bennbolton/BallBalancer/CAD/protractor image.png

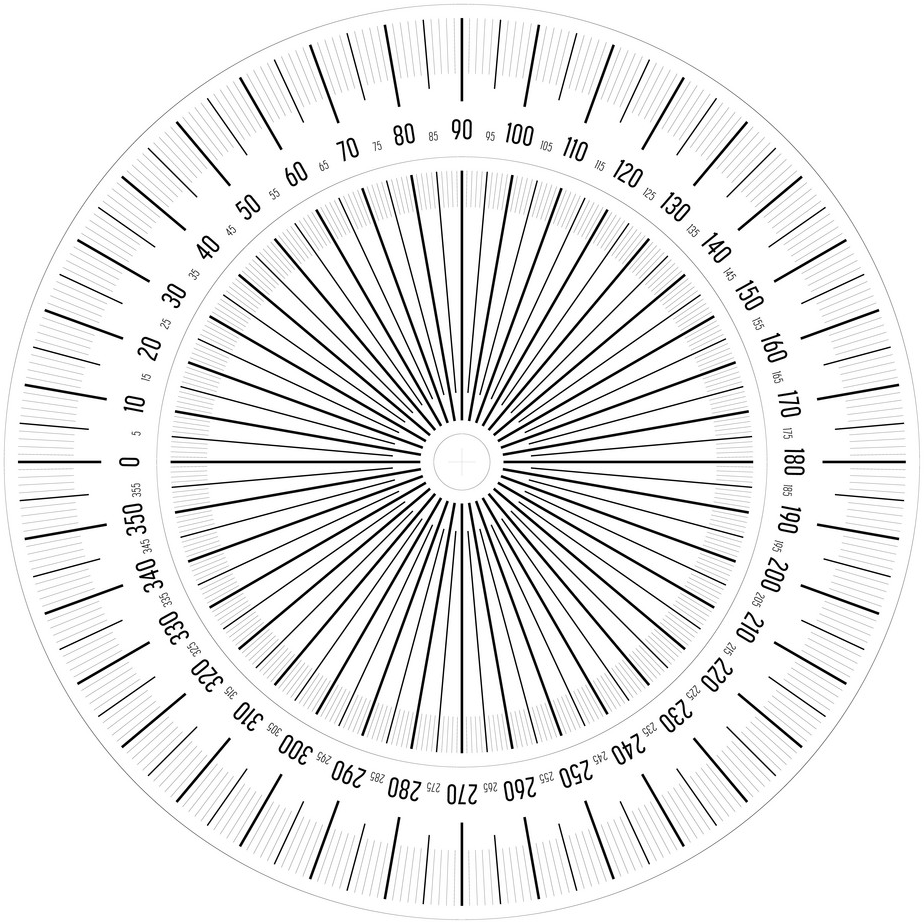
CAD/protractor image.png
