bennbolton/BallBalancer/Submissions/assets/mountRender.JPG

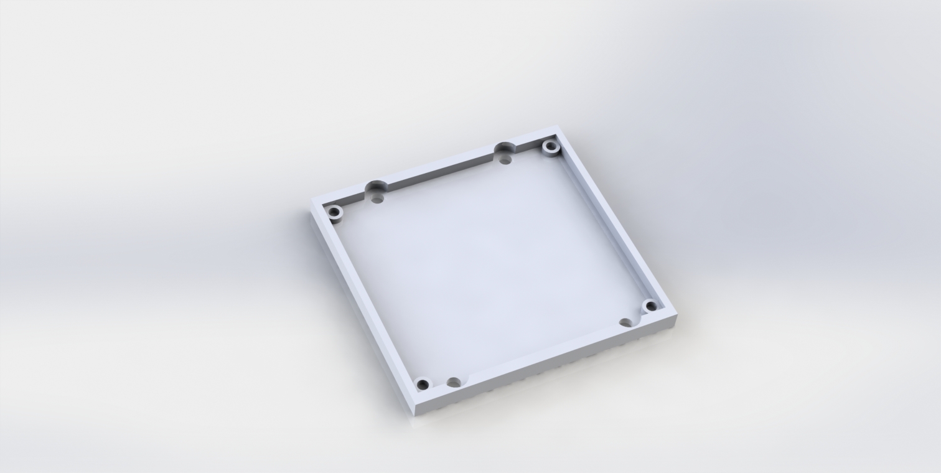
Submissions/assets/mountRender.JPG
