bennbolton/BallBalancer/Submissions/assets/response2.png

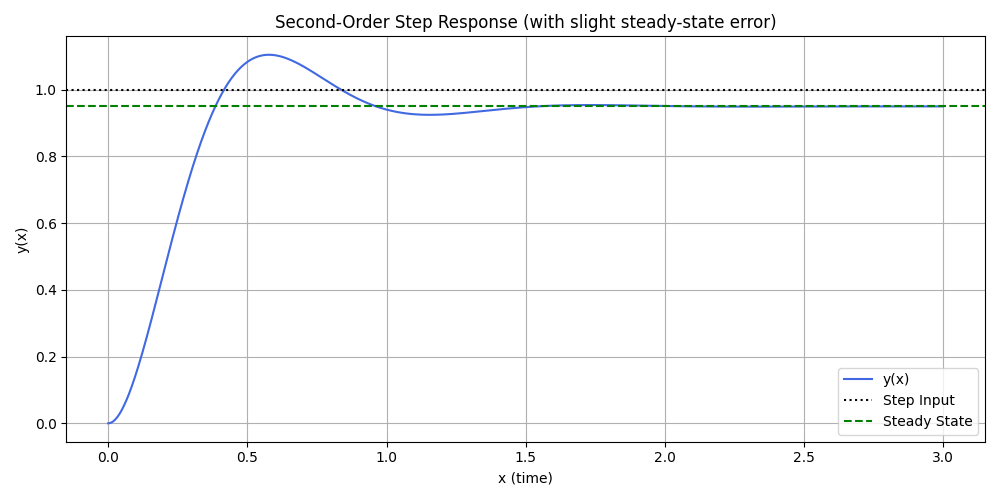
Submissions/assets/response2.png
