bennbolton/BallBalancer/Submissions/assets/response.png

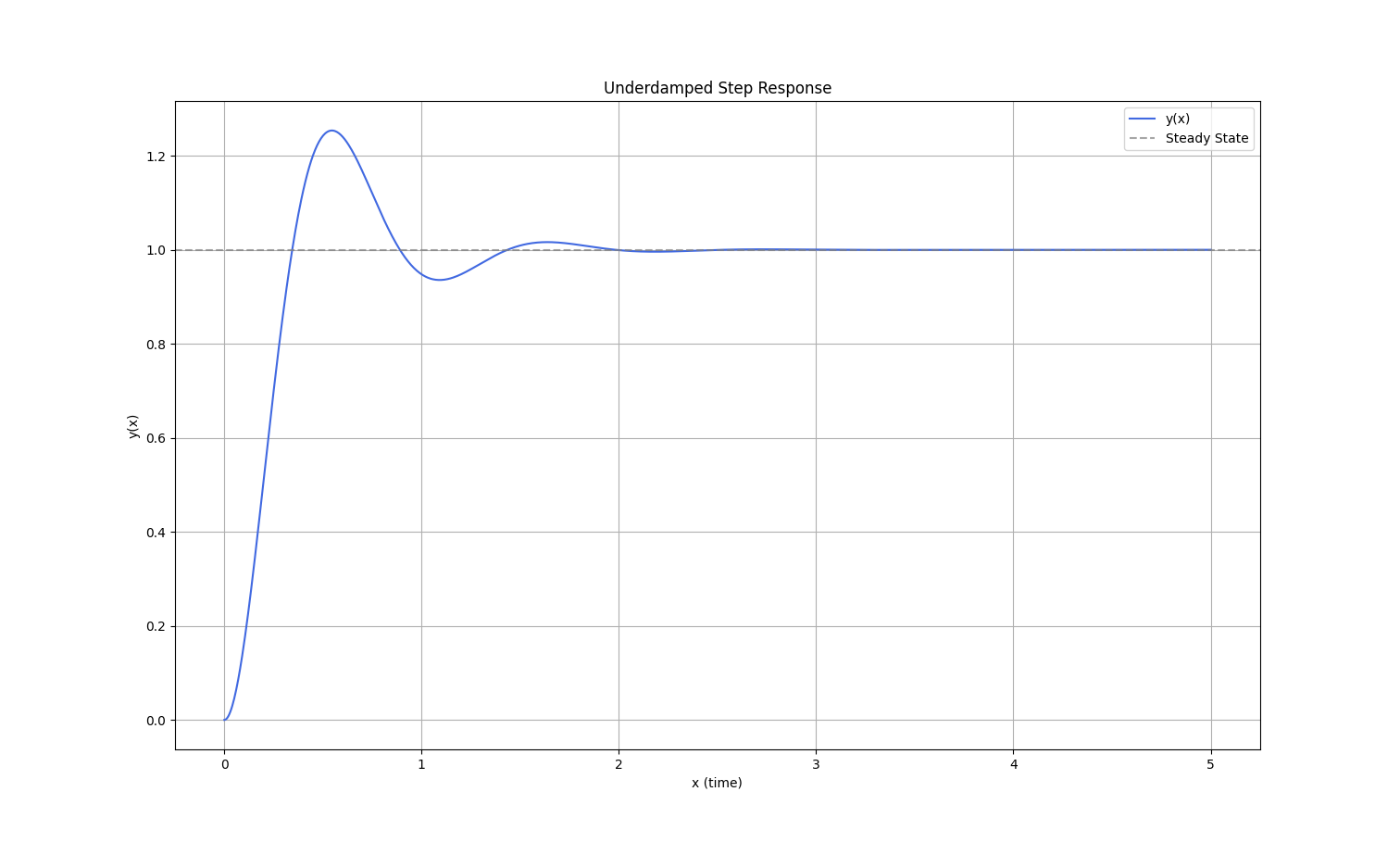
Submissions/assets/response.png
