bennbolton/BallBalancer/CAD/Parts/ESP32 Adapter mount 2.SLDPRT

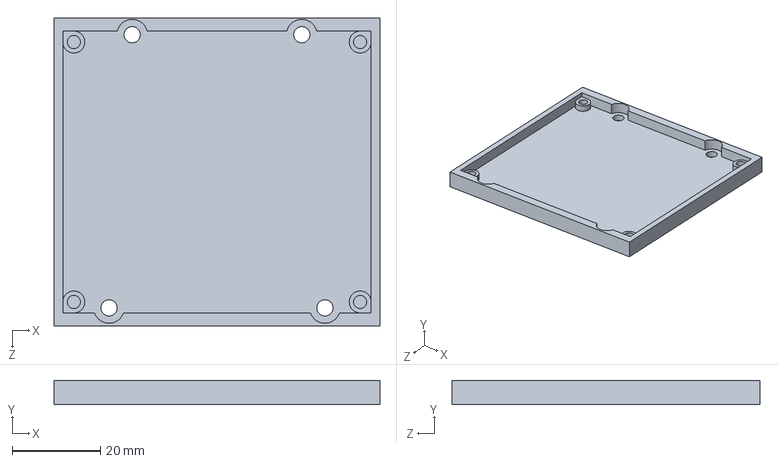
[picture p23: CAD file, 2025-08-05]
CAD/Parts/ESP32 Adapter mount 2.SLDPRT
74.0 x 5.50 x 70.0 mm
