bennbolton/BallBalancer/CAD/STL1/Assem1 - NEMA 23 - 76mm.prt-1.STL

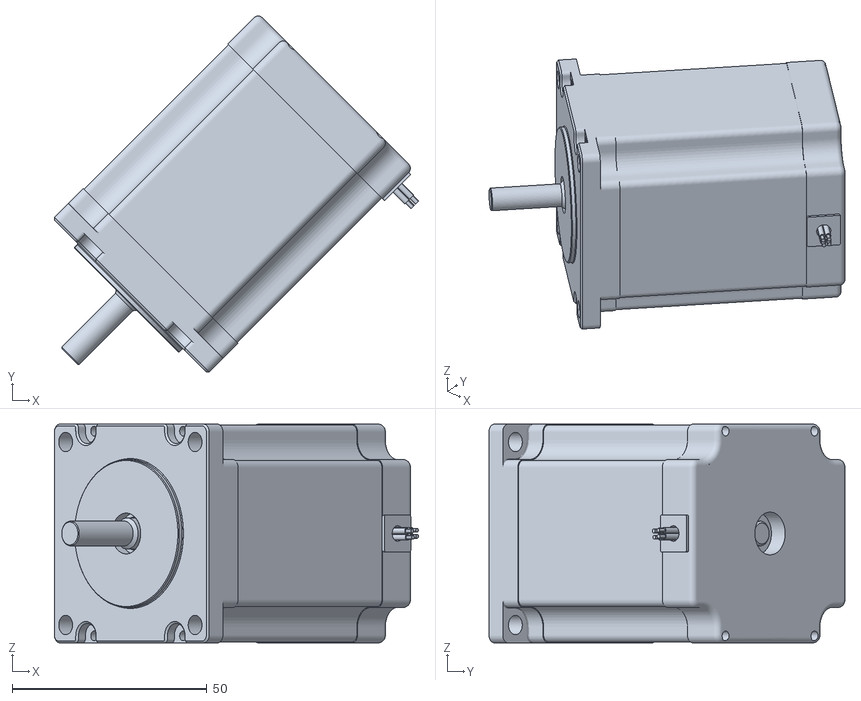
[picture p24: CAD file, 2025-08-05]
CAD/STL1/Assem1 - NEMA 23 - 76mm.prt-1.STL
93.5 x 91.4 x 56.2
