bennbolton/BallBalancer/CAD/Parts/BowlingBall.SLDPRT

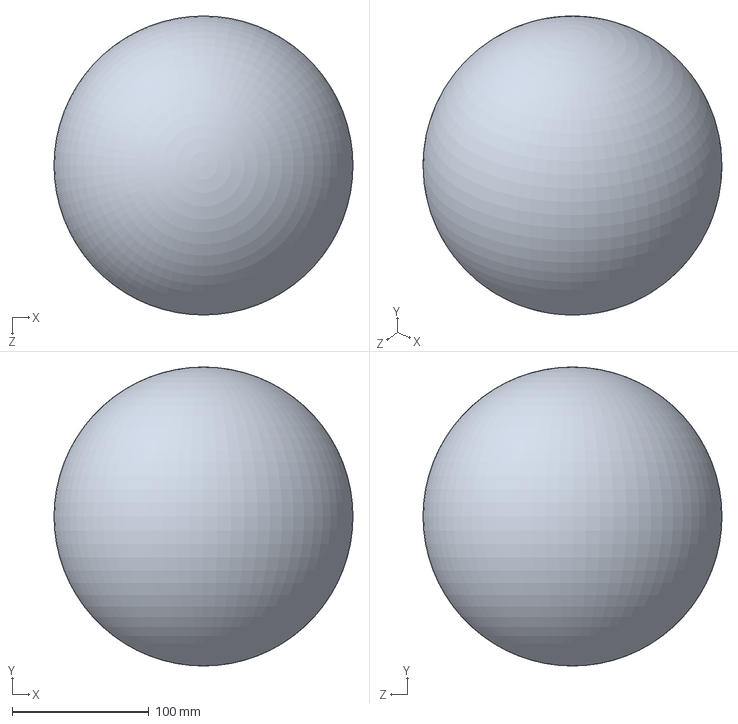
[picture p25: CAD file, 2025-08-05]
CAD/Parts/BowlingBall.SLDPRT
218.3 x 218.3 x 218.3 mm
