bennbolton/BallBalancer/CAD/STL1/Assem1 - nema23 45 degree mounting bracket.prt-1.STL

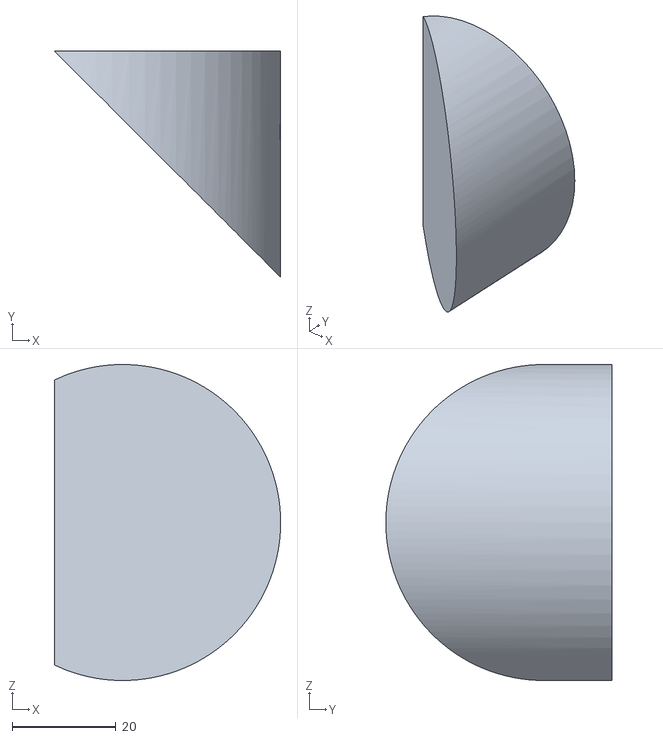
[picture p26: CAD file, 2025-08-05]
CAD/STL1/Assem1 - nema23 45 degree mounting bracket.prt-1.STL
43.7 x 43.7 x 61.0
