bennbolton/BallBalancer/CAD/Parts/OmniWheel.SLDPRT

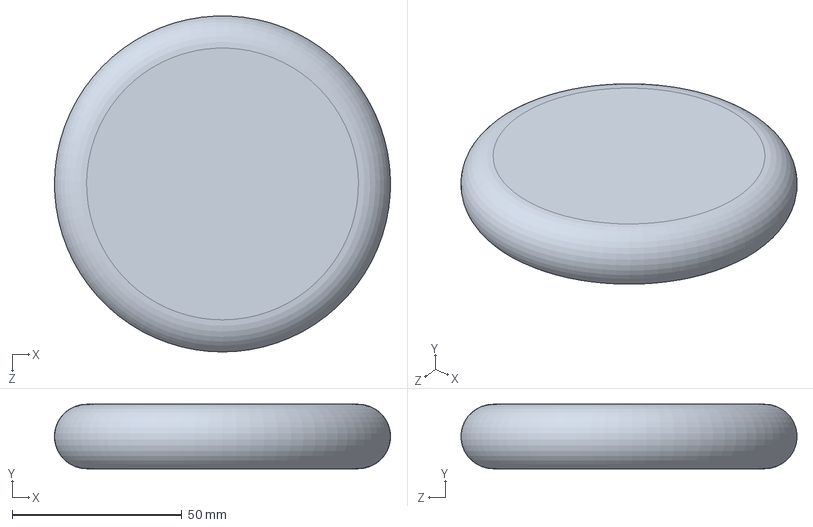
[picture p27: CAD file, 2025-08-05]
CAD/Parts/OmniWheel.SLDPRT
98.9 x 19.0 x 98.9 mm
