bennbolton/BallBalancer/CAD/STL1/Assem1 - TopPlate-2.STL

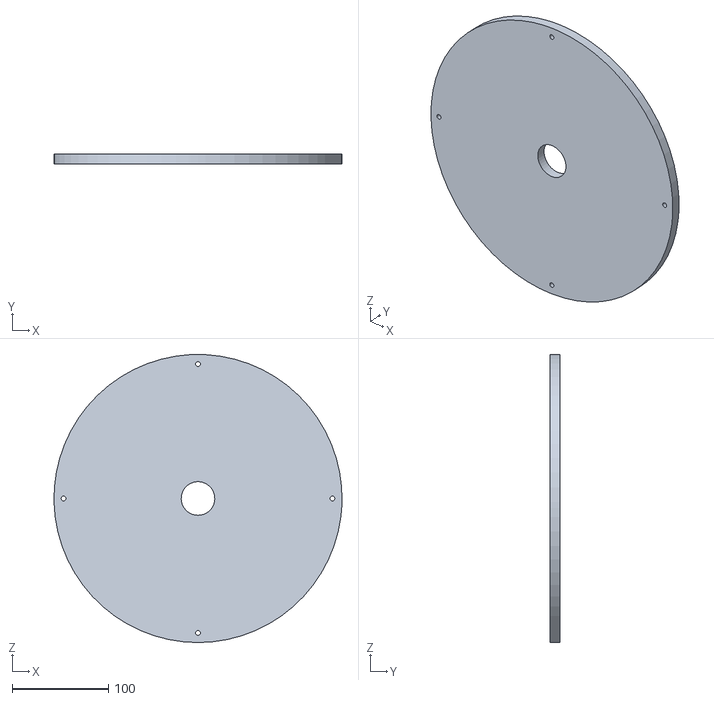
[picture p28: CAD file, 2025-08-05]
CAD/STL1/Assem1 - TopPlate-2.STL
299.9 x 10.0 x 300.0
