bennbolton/BallBalancer/CAD/STL1/Assem1 - SupportPole-3.STL

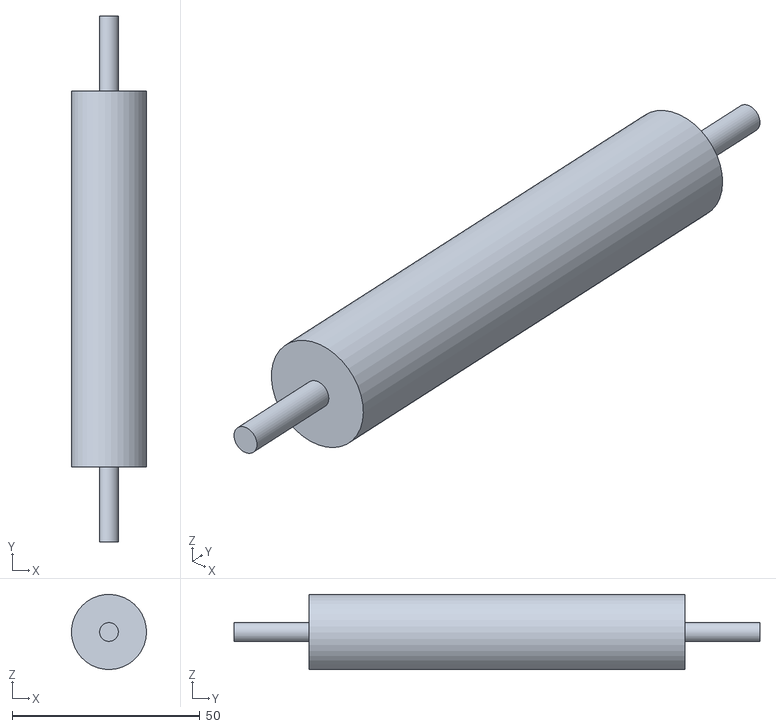
[picture p29: CAD file, 2025-08-05]
CAD/STL1/Assem1 - SupportPole-3.STL
20.0 x 140.0 x 20.0
