bennbolton/BallBalancer/CAD/Parts/ESP32 Adapter mount.SLDPRT

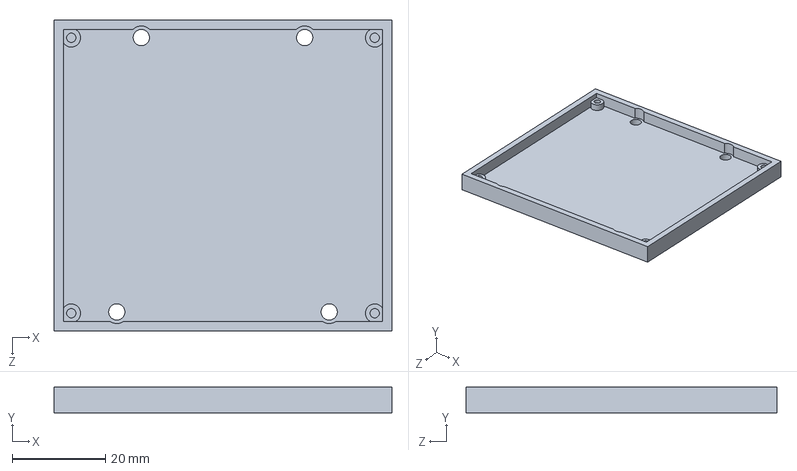
[picture p30: CAD file, 2025-08-05]
CAD/Parts/ESP32 Adapter mount.SLDPRT
72.4 x 5.50 x 66.6 mm
