bennbolton/BallBalancer/CAD/STL1/Assem1 - nema23 45 degree mounting bracket.prt-5.STL

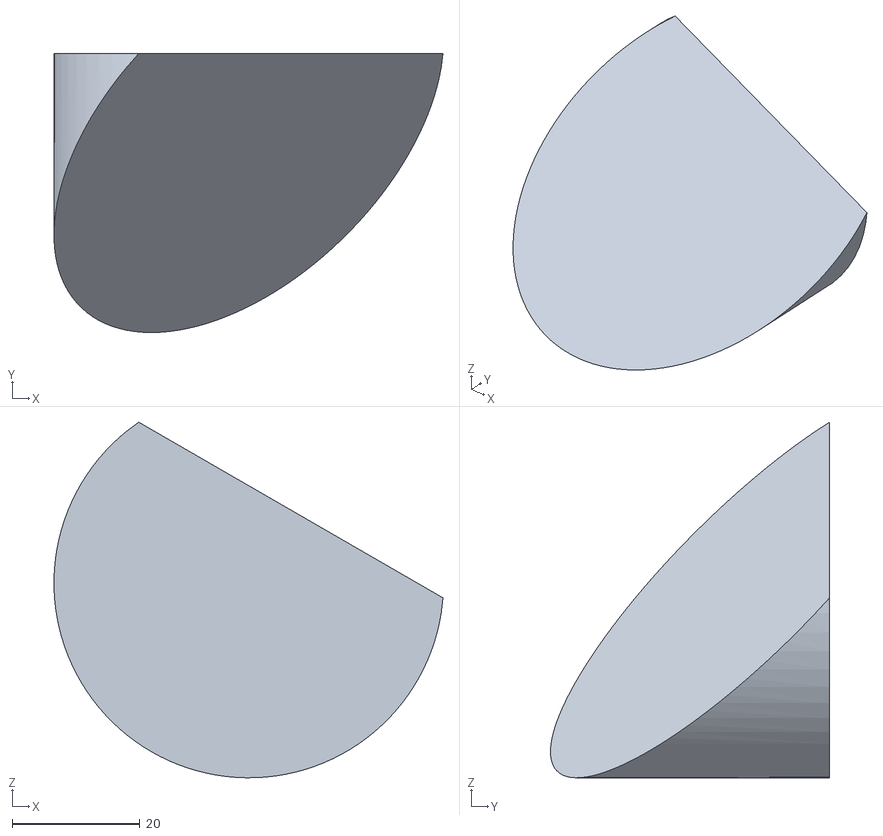
[picture p31: CAD file, 2025-08-05]
CAD/STL1/Assem1 - nema23 45 degree mounting bracket.prt-5.STL
60.9 x 43.7 x 55.7
