bennbolton/BallBalancer/CAD/Parts/ball_holder.SLDPRT

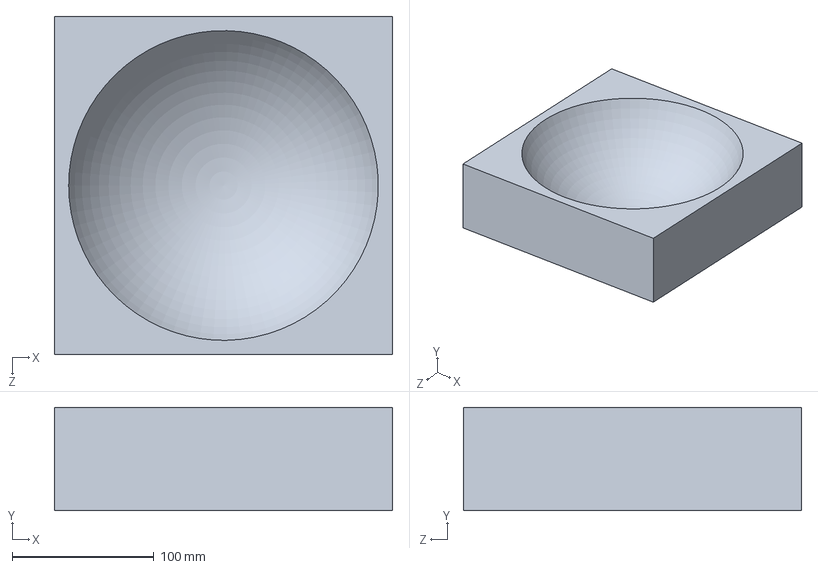
[picture p32: CAD file, 2025-08-05]
CAD/Parts/ball_holder.SLDPRT
238.3 x 72.8 x 238.3 mm
