bennbolton/BallBalancer/CAD/STL1/Assem1 - OmniWheel-1.STL

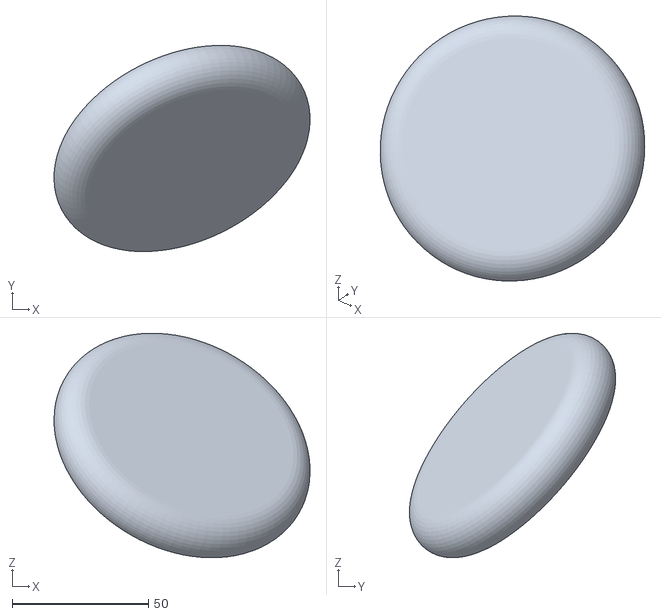
[picture p33: CAD file, 2025-08-05]
CAD/STL1/Assem1 - OmniWheel-1.STL
93.8 x 75.5 x 82.2
