bennbolton/BallBalancer/CAD/STL1/Assem1 - NEMA 23 - 76mm.prt-3.STL

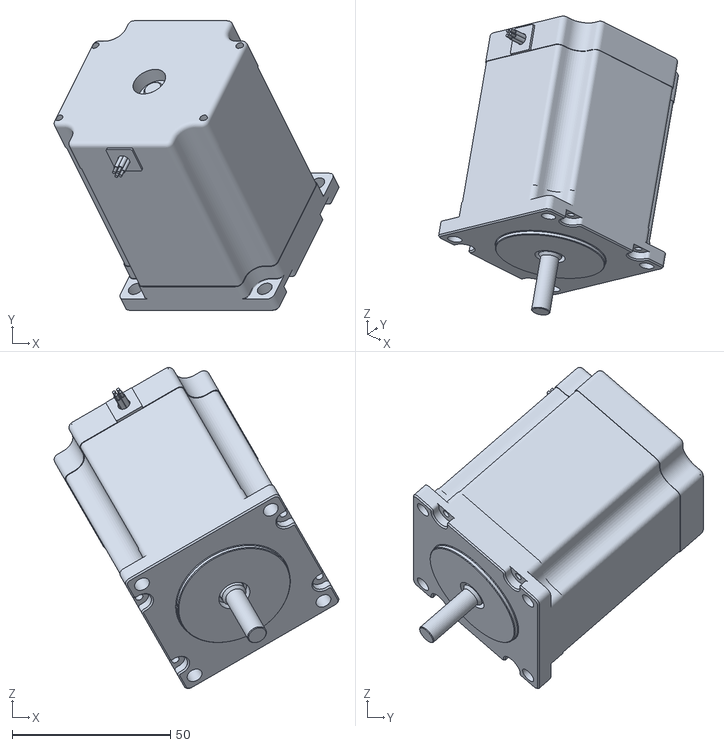
[picture p34: CAD file, 2025-08-05]
CAD/STL1/Assem1 - NEMA 23 - 76mm.prt-3.STL
89.9 x 91.4 x 101.4
