bennbolton/BallBalancer/CAD/STL1/Assem1 - OmniWheel-3.STL

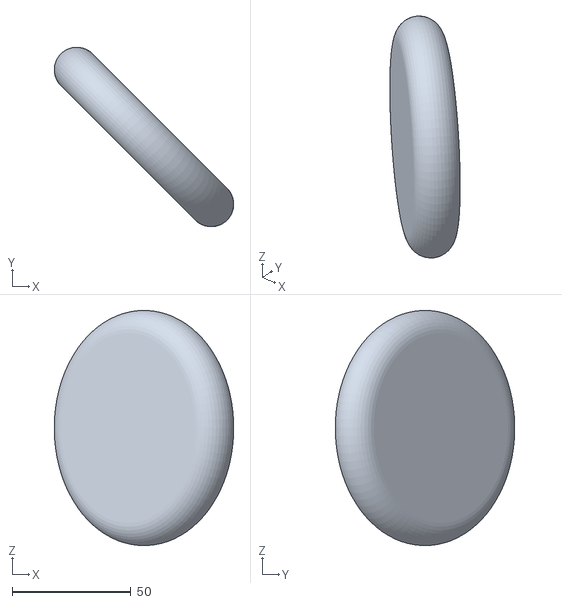
[picture p35: CAD file, 2025-08-05]
CAD/STL1/Assem1 - OmniWheel-3.STL
75.5 x 75.5 x 98.9
