bennbolton/BallBalancer/(list of files, cad)

Other CAD files:
CAD/Parts/TopPlate.SLDPRT
CAD/Parts/SupportPole.SLDPRT
CAD/STL1/Assem1 - TopPlate-1.STL
CAD/STL1/Assem1 - NEMA 23 - 76mm.prt-2.STL
CAD/STL1/Assem1 - SupportPole-1.STL
CAD/STL1/Assem1 - SupportPole-4.STL
CAD/STL1/Assem1 - OmniWheel-2.STL
CAD/STL1/Assem1 - nema23 45 degree mounting bracket.prt-6.STL
CAD/STL1/Assem1 - SupportPole-2.STL
CAD/Parts/ESP32 Adapter mount 2.STL
CAD/Parts/ESP32 Adapter mount.STL
