bennbolton/BallBalancer/Logbook/Gyro Calibration Data.md

---- GYROSCOPE BIAS (dps) ----
gx bias = -0.434390
gy bias = -0.205885
gz bias = -0.099030

---- GYROSCOPE BIAS (dps) ----
gx bias = -0.534443
gy bias = -0.202985
gz bias = -0.219290

---- GYROSCOPE BIAS (dps) ----
gx bias = -0.552145
gy bias = -0.217382
gz bias = -0.145290

---- GYROSCOPE BIAS (dps) ----
gx bias = -0.510893
gy bias = -0.217573
gz bias = -0.087237

---- GYROSCOPE BIAS (dps) ----
gx bias = -0.535321
gy bias = -0.158954
gz bias = -0.153191

Gx = -0.51
Gy = -0.2
Gz = -0.14
