bennbolton/BallBalancer/Logbook/Tuning Values.md

| Kp | Ki | Kd | Observation |
| ---- | ----- | ----- | --- |
| 0.05 | 0 | 0 | can balance upright but doesnt respond to pushes |
| 0.05 | 0 | 0.01  | Very jittery |
| 0.05 | 0 | 0.001 | Actually kind of works |
| 0.05 | 0.001 | 0.001 | Does not balance |
