bennbolton/BallBalancer/Logbook/IMU trouble.md

Magnetometer was not sending information through
Its a separate I2C device which library didn't setup correctly
Gyro drifting heavily
Calibration methods using python file from a GitHub [here](https://github.com/jremington/ICM_20948-AHRS/tree/main)

Found a Simulink plugin which seems to work even without calibration
