bennbolton/BallBalancer/Logbook/Issues Identified.md

- [ ] The gap between each section of the omni-wheels can cause issues and non-fluid turning at low speeds

- [x] stepper drivers were current limited but managed to fix it
