bennbolton/BallBalancer/Logbook/MOTOR PLAN.md

# Stepper

**AD9833**
- Need three boards to control each motor. Can set a frequency quickly and dynamically to take load off of the microcontroller

# DC

**Needs:**
- three expensive motors
- new mounts
- new drivers
- new theory
