bennbolton/BallBalancer/Logbook/Useful Links.md

# Papers
- [Source that says that torque control with stepper is possible but difficult](https://www.analog.com/en/lp/001/field-oriented-control.html)
- [Good Paper](https://essay.utwente.nl/65559/1/vanderBlonk_MSc_EEMCS.pdf)
- [Kugle Project](https://github.com/mindThomas/Kugle-MATLAB)
- [Micro-step vs torque paper](http://www.diva-portal.org/smash/get/diva2:1201175/FULLTEXT01.pdf)
- [Relevant paper pro steppers](https://www.fujipress.jp/main/wp-content/themes/Fujipress/pdf_subscribed.php)
- [Similar student project using steppers](https://github.com/howarewoo/Ballbot/blob/master/Ballbot%20-%20Midterm%20Report.pdf)
- [PID + stepper paper](https://www.matec-conferences.org/articles/matecconf/pdf/2019/01/matecconf_cmes2018_02005.pdf)
- [Original BallBot paper](http://www.msl.ri.cmu.edu/publications/pdfs/isrr05.pdf)
- [Full state control](https://www.researchgate.net/publication/373389781_H_optimal_full-state_feedback_control_for_a_ball-balancing_robot)
- [very detailed control paper](https://webthesis.biblio.polito.it/8751/1/tesi.pdf)
- [Another modelling paper](https://www.research-collection.ethz.ch/bitstream/handle/20.500.11850/154271/eth-7943-01.pdf)

# Links
-  [Similar Project Video](https://www.youtube.com/embed/641GHMW7EOU?si=zLCUogh5cBpnUnvu)
- [Mag Callibration github](https://github.com/jremington/ICM_20948-AHRS/tree/main)
- [Unity robotics integration](https://github.com/fsstudio-team/ZeroSimROSUnity)
- [matlab example control git](https://github.com/howarewoo/Ballbot)
