bennbolton/BallBalancer/Logbook/Mag Cal Data.md

-116.649457 ,140.699077 ,204.736907
-127.827740 ,128.067625 ,208.449048
-115.766135 ,137.980648 ,211.516894
-115.053263 ,134.931767 ,206.669094
-105.633685 ,138.177038 ,211.648966
-113.239528 ,144.143606 ,202.142316
-116.664963 ,134.654955 ,212.478410
-121.818090 ,127.868367 ,216.023511
-113.413906 ,134.250490 ,204.226834
-121.802584 ,133.912489 ,208.282009
-133.820451 ,125.601826 ,205.977471
-135.558003 ,121.371414 ,208.628943
-148.661227 ,106.844154 ,198.261882
-150.370262 ,96.430145 ,211.987044
-162.437799 ,89.147310 ,204.649357
-170.451641 ,67.681163 ,206.289936
-168.039022 ,64.630145 ,202.297195
-169.220854 ,43.050844 ,209.857151
-160.655221 ,37.605438 ,226.837360
-167.613655 ,37.248666 ,212.622384
-164.735429 ,45.779495 ,224.767549
-166.039761 ,33.292929 ,210.319600
-172.113727 ,23.250385 ,213.160123
-184.899210 ,16.421111 ,214.107029
-180.791916 ,10.772636 ,214.406140
-169.079639 ,4.383101 ,216.505268
-166.481350 ,9.448493 ,213.829933
-173.907456 ,26.161660 ,201.370849
-173.170567 ,10.850191 ,216.171288
-173.067299 ,18.357199 ,212.525282
-179.893948 ,19.323837 ,205.737991
-172.424964 ,9.438539 ,211.253751
-171.427082 ,12.450414 ,217.789656
-166.452832 ,3.264896 ,224.903623
-174.069108 ,5.782661 ,219.701682
-163.020892 ,6.639687 ,223.975125
-165.662632 ,-1.769902 ,228.456029
-169.079639 ,4.383101 ,216.505268
-143.987209 ,-15.260844 ,229.334953
-138.756181 ,-13.943844 ,239.327814
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
