bennbolton/BallBalancer/Logbook/Resources/MagShowing0.png

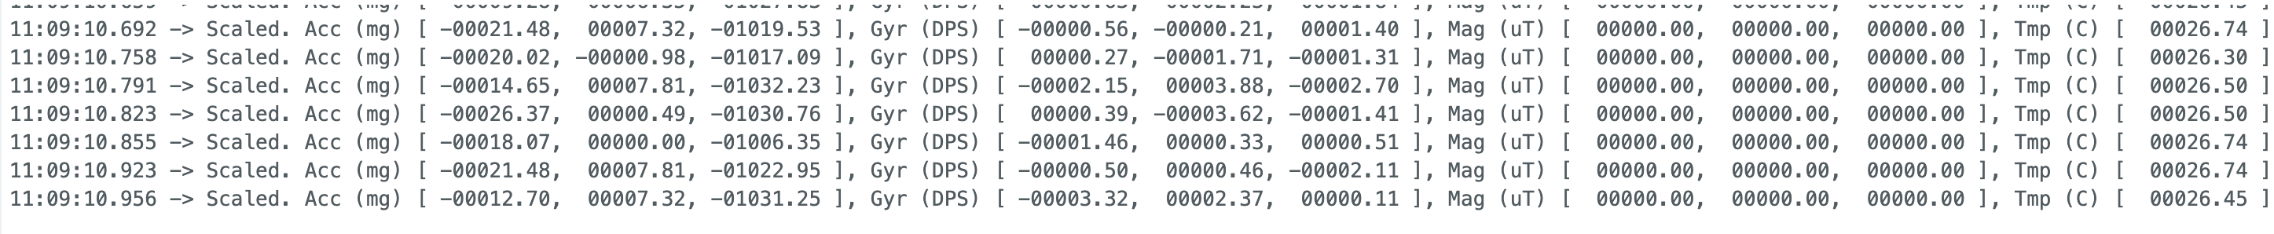
Logbook/Resources/MagShowing0.png
