bennbolton/BallBalancer/Submissions/F223612-poster.pdf

# Control system to balance a robot on a moving sphere

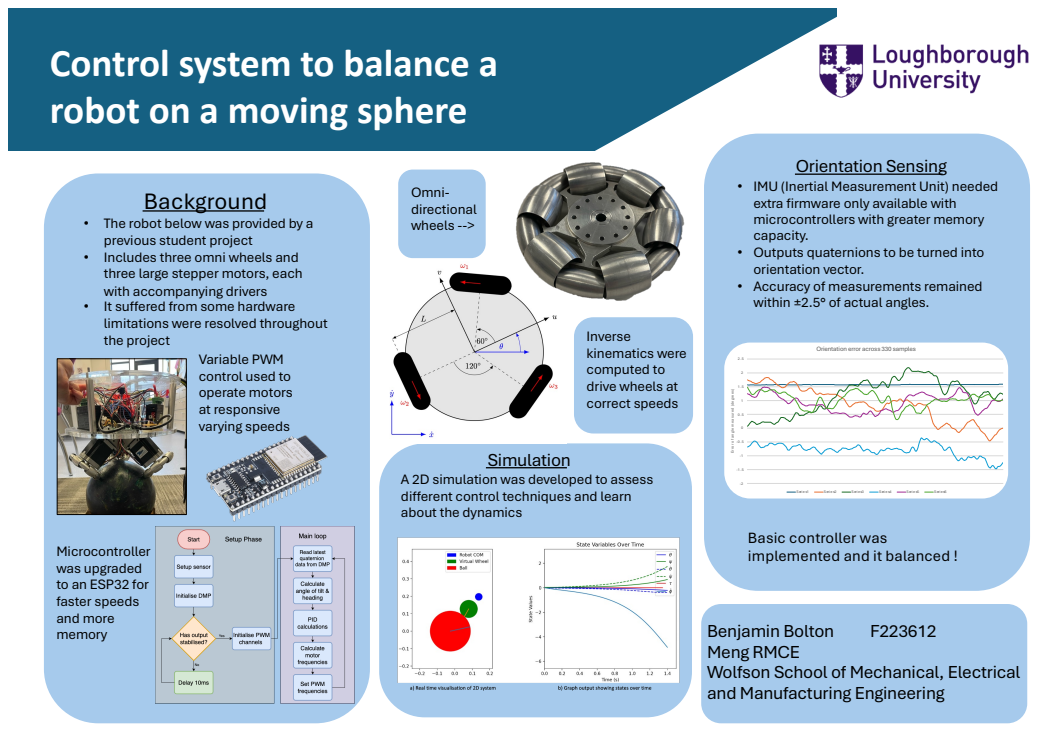
[picture p37: page 1]
Benjamin Bolton; Serie s1; Serie s2; Serie s3; Serie s4; Serie s5; Serie s6; Simulation; Orientation Sensing; Omni- directional wheels -->

Background • The robot below was provided by a

• IMU (Inertial Measurement Unit) needed
extra firmware only available with
microcontrollers with greater memory
capacity.
• Outputs quaternions to be turned into
orientation vector.
• Accuracy of measurements remained
within ±2.5° of actual angles.

previous student project
• Includes three omni wheels and
three large stepper motors, each
with accompanying drivers
• It suffered from some hardware
limitations were resolved throughout
the project

Inverse
kinematics were
computed to
drive wheels at
correct speeds

Variable PWM
control used to
operate motors
at responsive
varying speeds

Orientation error across 330 samples

Error of angle measured (degrees)

A 2D simulation was developed to assess
different control techniques and learn
about the dynamics

Basic controller was
implemented and it balanced !

Microcontroller
was upgraded
to an ESP32 for
faster speeds
and more
memory

Meng RMCE
Wolfson School of Mechanical, Electrical
and Manufacturing Engineering
